ZajacPi/Davie-Robot-Arm/docs/Photos/robot_assembled.jpeg

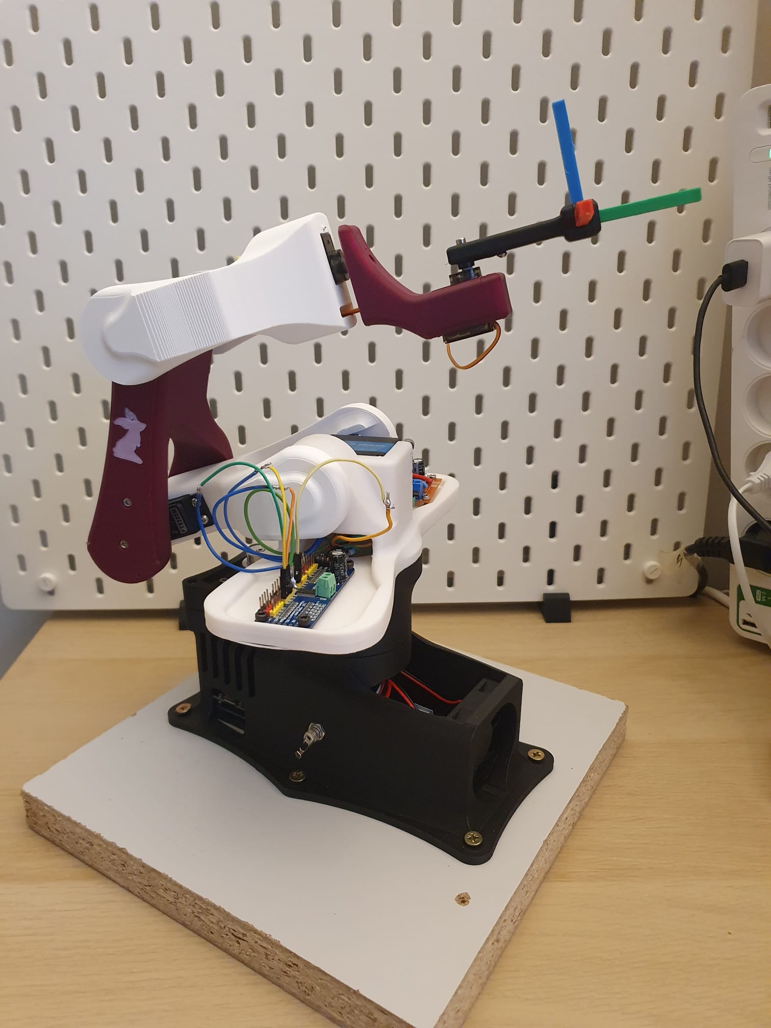
docs/Photos/robot_assembled.jpeg
