ZajacPi/Davie-Robot-Arm/docs/Photos/brass_insert.jpeg

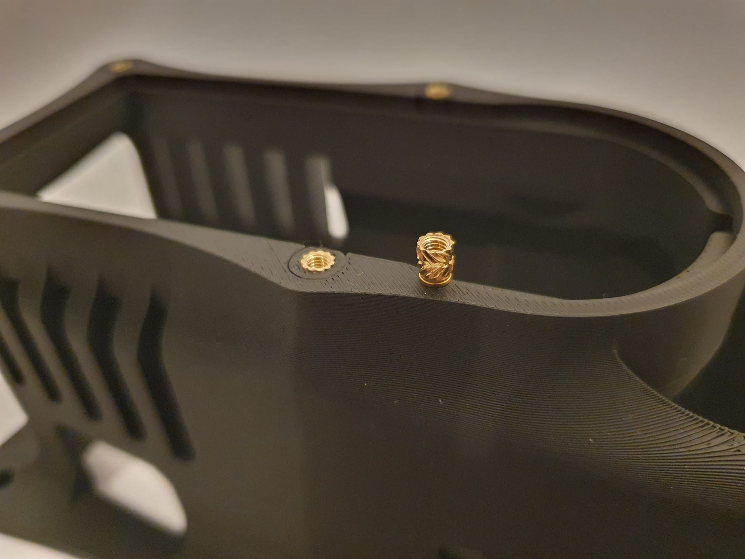
docs/Photos/brass_insert.jpeg
