ZajacPi/Davie-Robot-Arm/Documentation/Diagrams.pptx

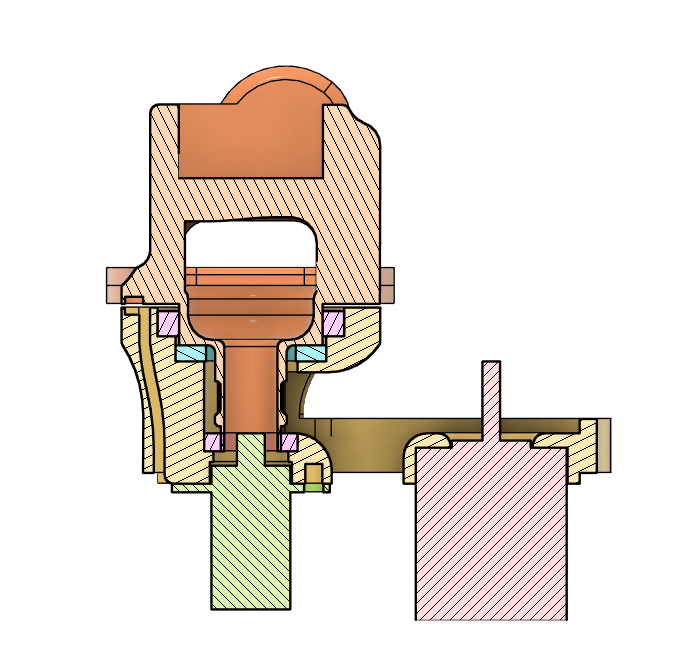
[picture p3: figure]

Rotating first axis

Magnet slot

Hollow shaft for routing cables

Rolling bearings

Hall-effect sensor slot with tunel for routing cables

Needle bearing

Hole for brass insert

Slip ring

Stepper motor

## Slide 2

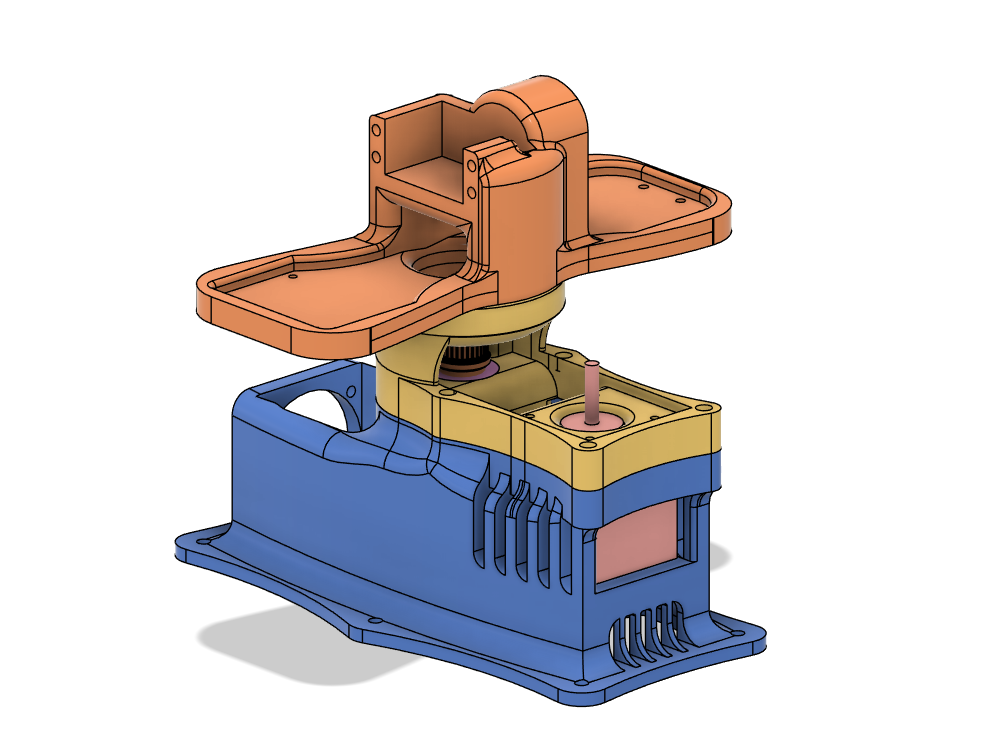
[picture p4: figure]
Obraz zawierający kreskówka Zawartość wygenerowana przez AI może być niepoprawna.

## Slide 3

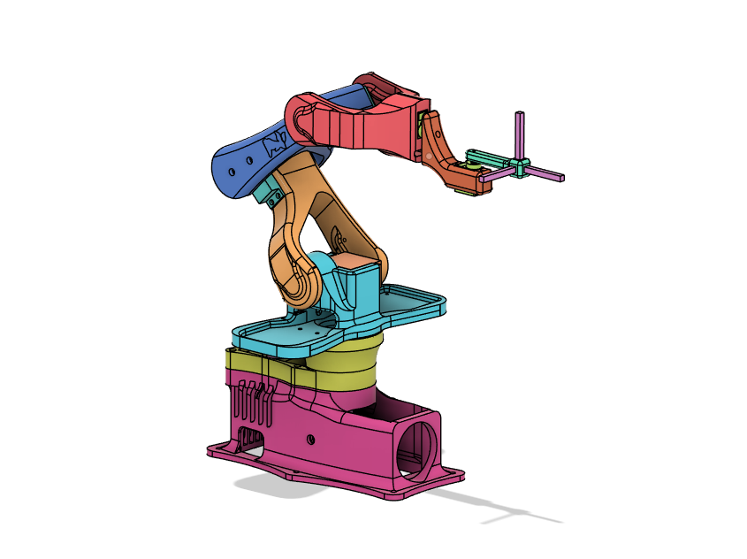
[picture p5: figure]
Obraz zawierający zabawka, rysowanie, kreskówka, szkic Zawartość wygenerowana przez AI może być niepoprawna.
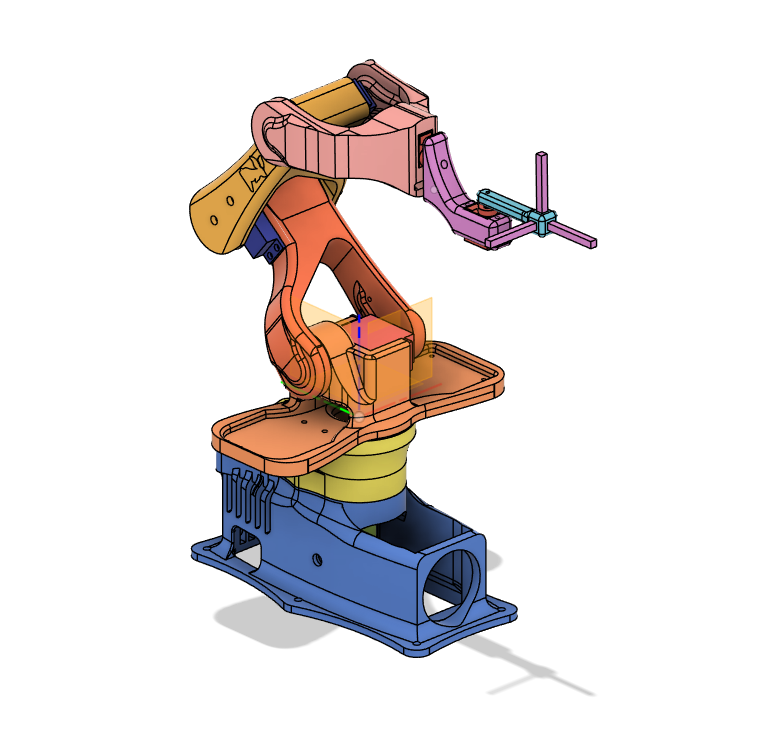
[picture p6: figure]
Obraz zawierający zabawka, rysowanie, kreskówka Zawartość wygenerowana przez AI może być niepoprawna.
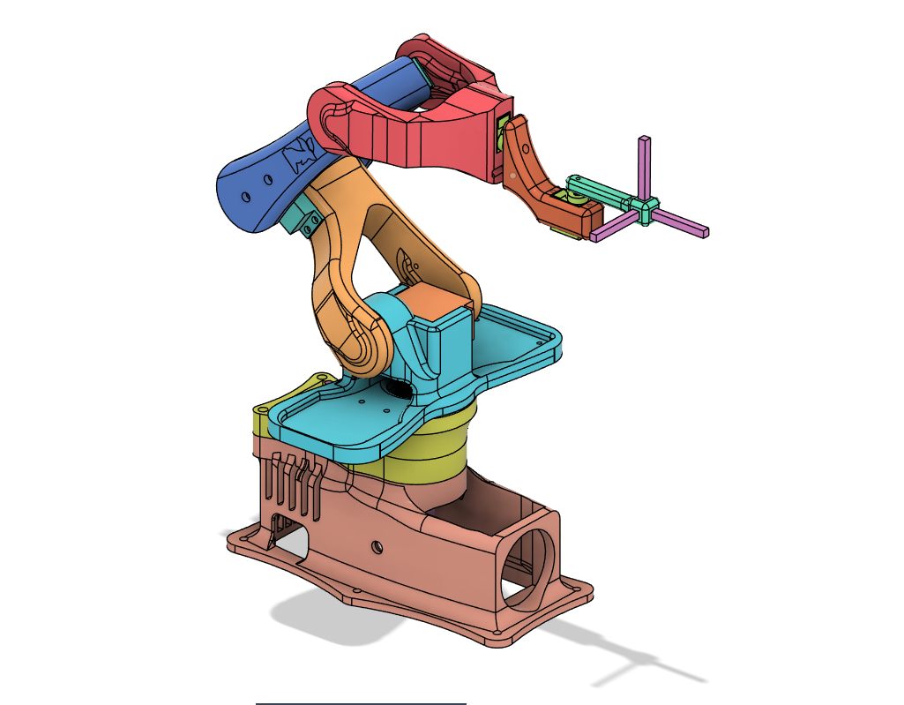
[picture p7: figure]
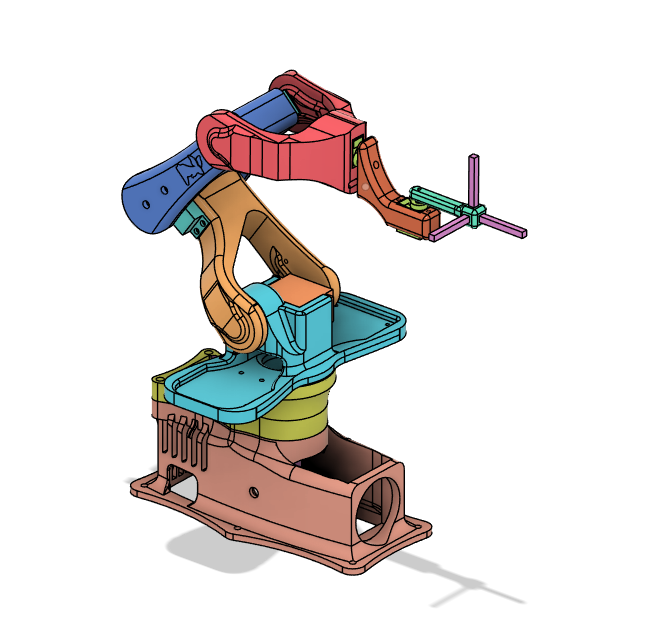
[picture p8: figure]
Obraz zawierający rysowanie, szkic, zabawka, kreskówka Zawartość wygenerowana przez AI może być niepoprawna.
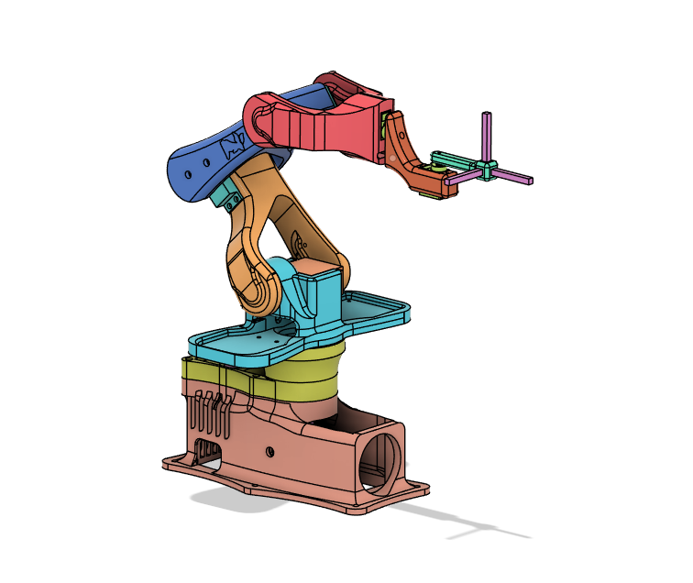
[picture p9: figure]
Obraz zawierający rysowanie, zabawka, szkic, kreskówka Zawartość wygenerowana przez AI może być niepoprawna.

## Slide 4

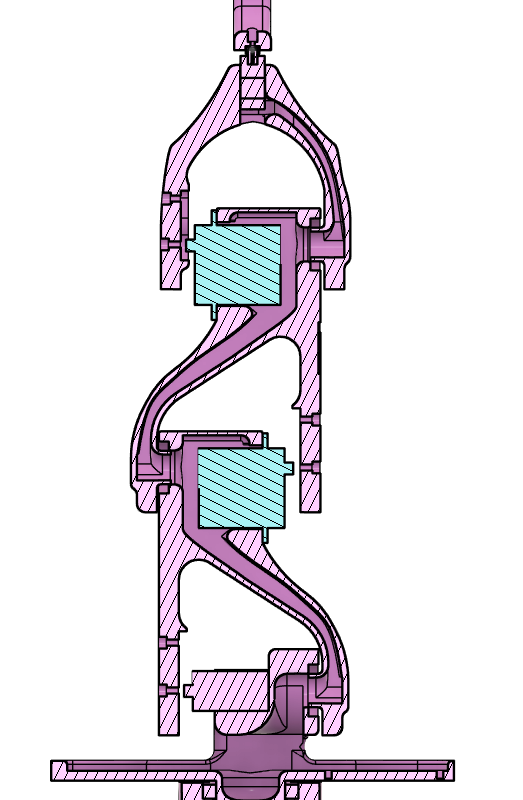
[picture p10: figure]
Obraz zawierający szkic, rysowanie, diagram, sztuka Zawartość wygenerowana przez AI może być niepoprawna.
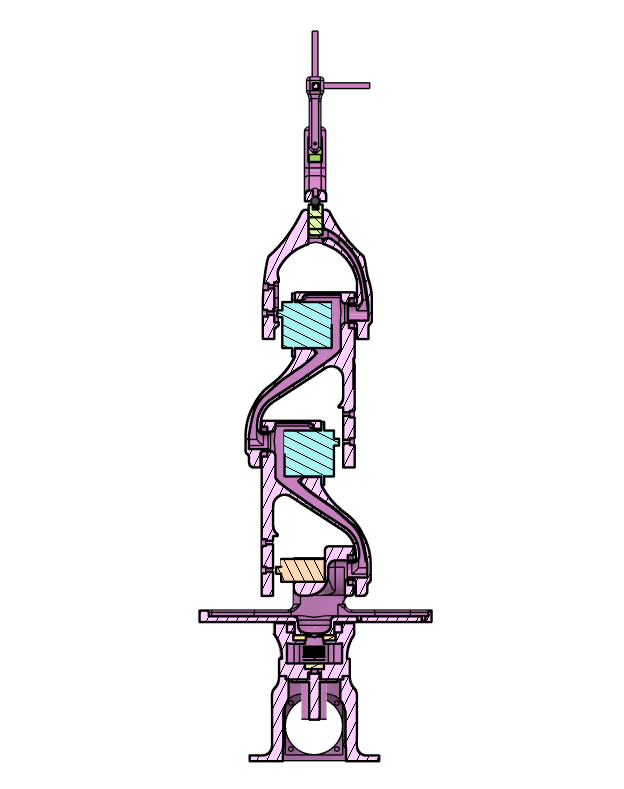
[picture p11: figure]
Obraz zawierający szkic, rysowanie, sztuka, Sztuka dziecięca Zawartość wygenerowana przez AI może być niepoprawna.
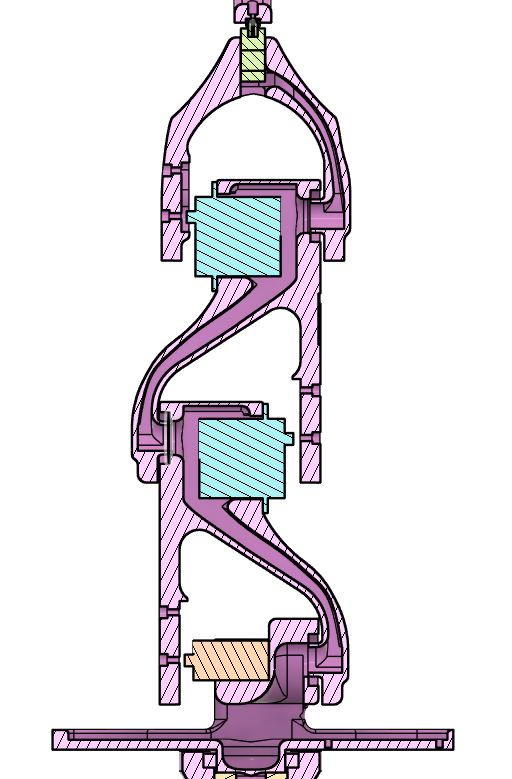
[picture p12: figure]
Obraz zawierający szkic, rysowanie, sztuka, ilustracja Zawartość wygenerowana przez AI może być niepoprawna.
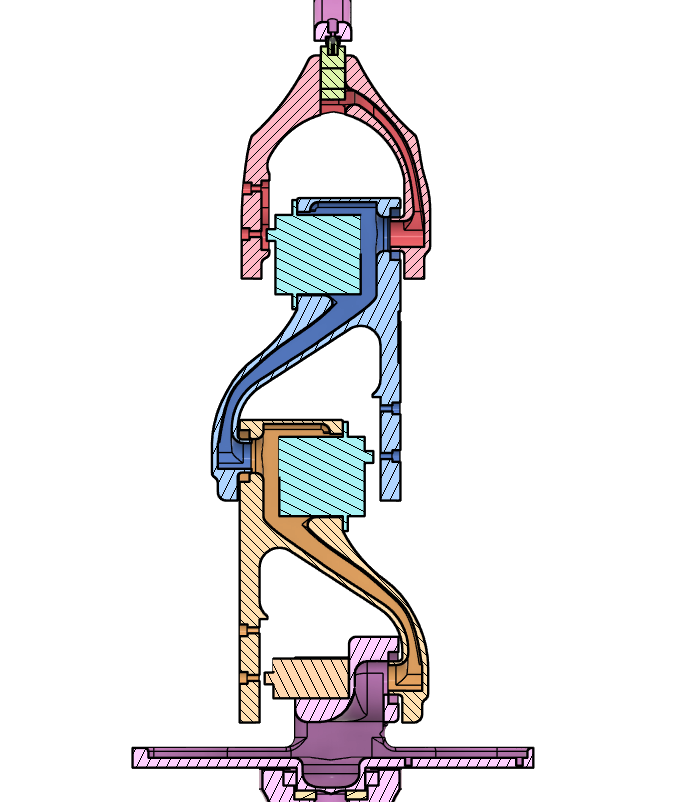
[picture p13: figure]
Obraz zawierający rysowanie, szkic, clipart, Sztuka dziecięca Zawartość wygenerowana przez AI może być niepoprawna.
