ZajacPi/Davie-Robot-Arm/david_ws/frames_2025-11-15_11.10.46.pdf

view_frames Result

Recorded at time: 1763201446.6545582

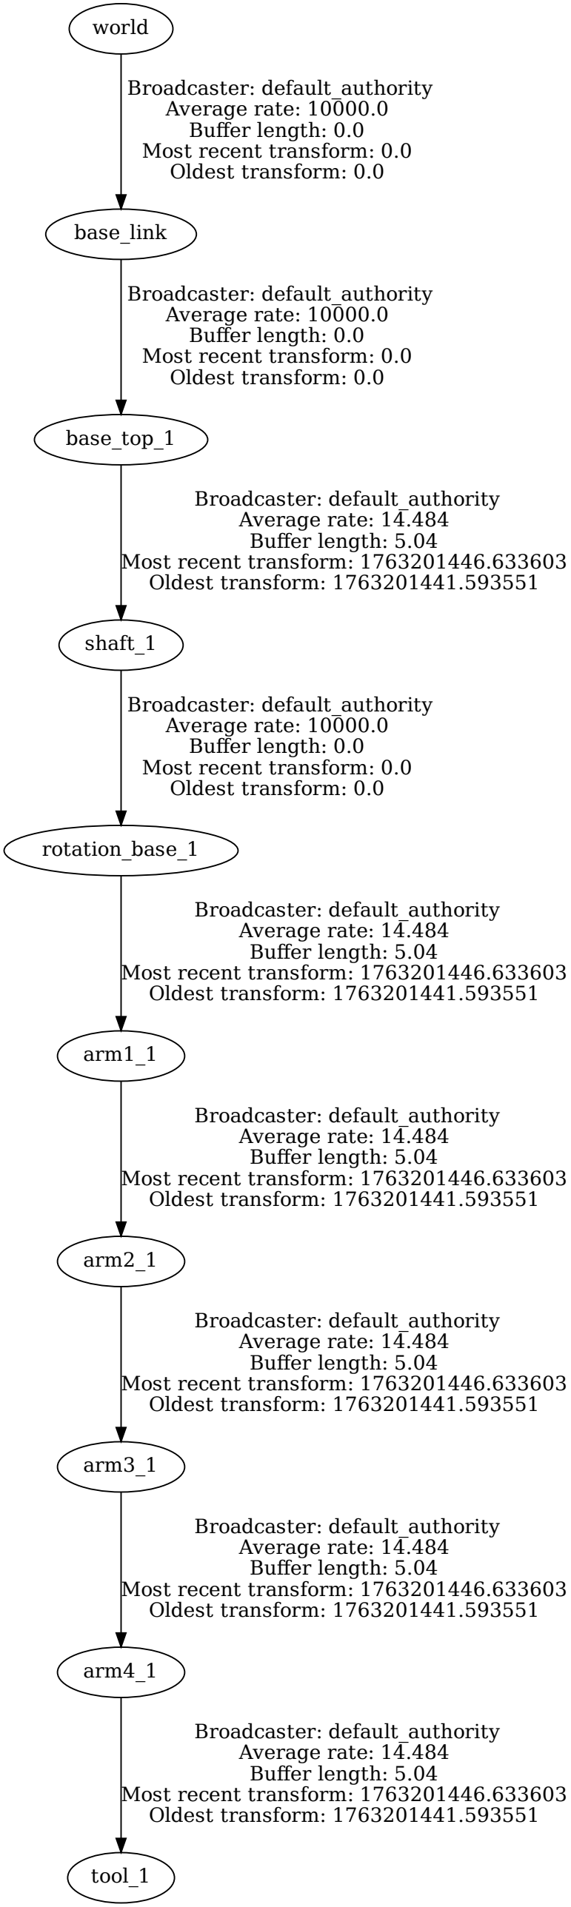
[picture p14: figure]
base_link; base_top_1; Broadcaster: default_authority Average rate: 10000.0 Buffer length: 0.0 Most recent transform: 0.0 Oldest transform: 0.0; shaft_1; Broadcaster: default_authority Average rate: 14.484 Buffer length: 5.04 Most recent transform: 1763201446.633603 Oldest transform: 1763201441.593551; world; rotation_base_1; arm1_1; arm2_1; arm3_1; arm4_1; tool_1
