ZajacPi/Davie-Robot-Arm/david_ws/frames_2025-11-27_08.39.21.pdf

view_frames Result

Recorded at time: 1764229161.7200086

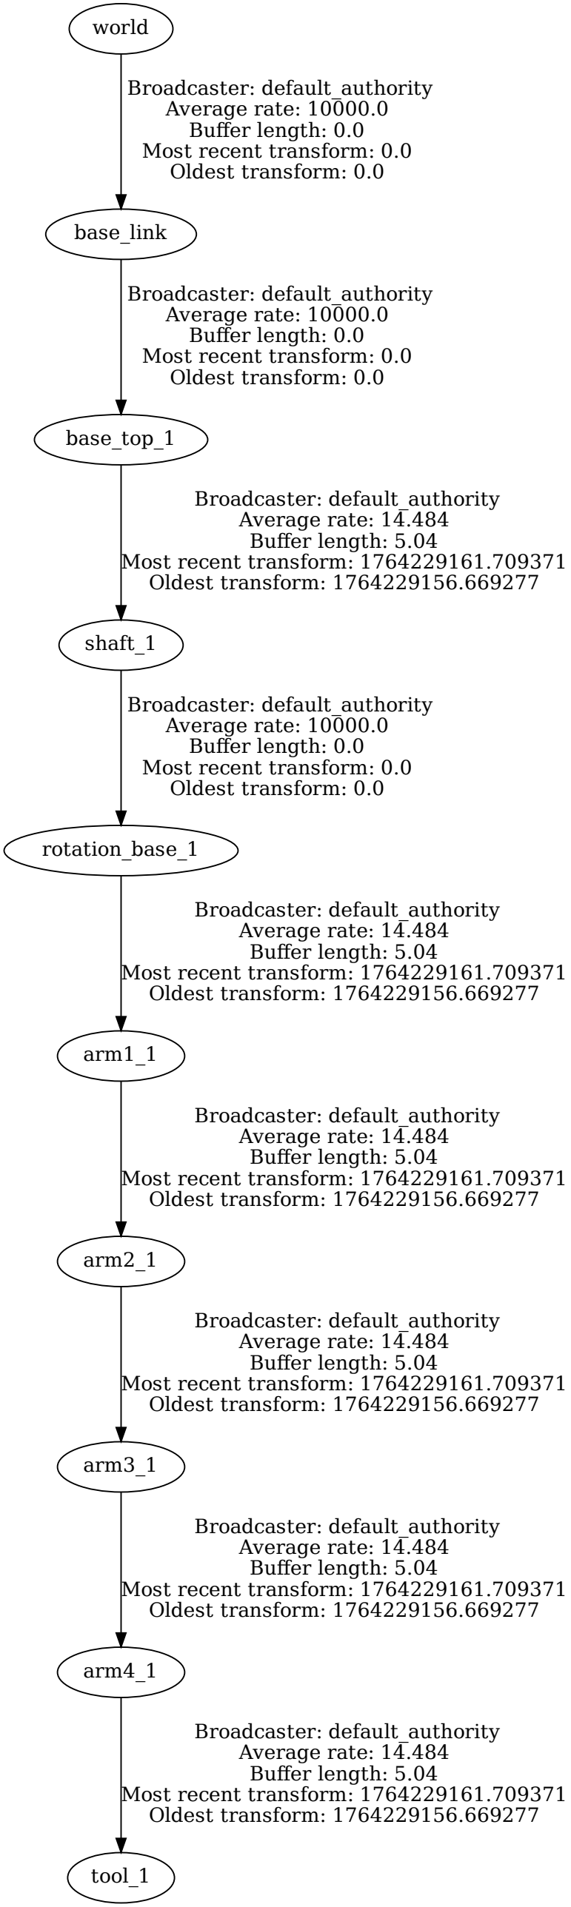
[picture p15: figure]
world; base_link; Broadcaster: default_authority Average rate: 10000.0 Buffer length: 0.0 Most recent transform: 0.0 Oldest transform: 0.0; base_top_1; shaft_1; Broadcaster: default_authority Average rate: 14.484 Buffer length: 5.04 Most recent transform: 1764229161.709371 Oldest transform: 1764229156.669277; rotation_base_1; arm1_1; arm2_1; arm3_1; arm4_1; tool_1
