ZajacPi/Davie-Robot-Arm/docs/Diagrams/base_diagram.jpg

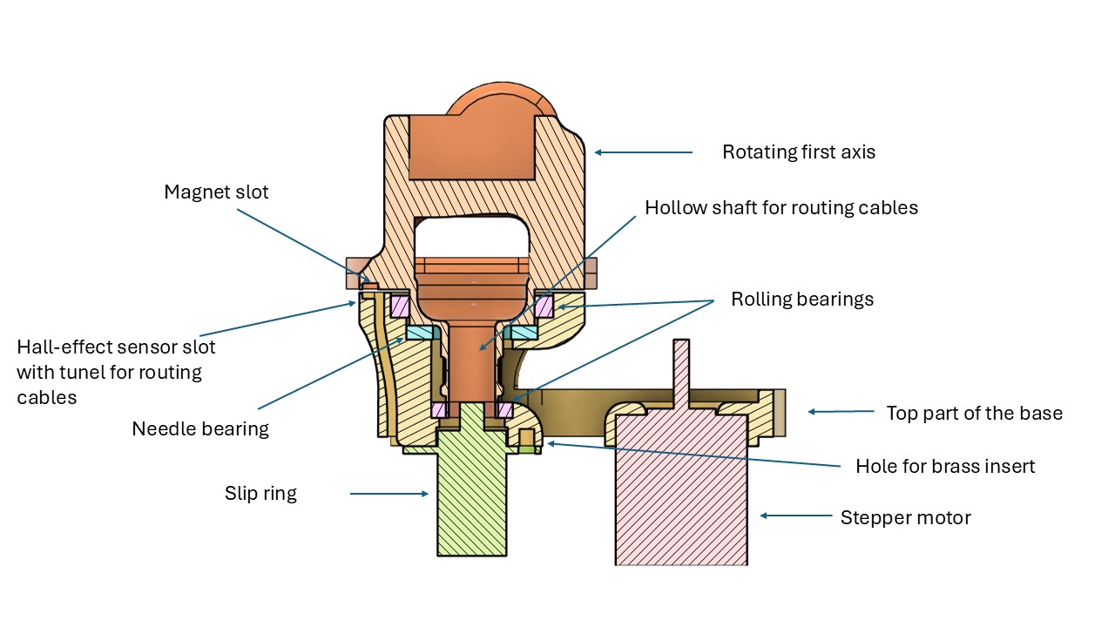
docs/Diagrams/base_diagram.jpg
