ZajacPi/Davie-Robot-Arm/docs/Diagrams/power_distribution_diagram.png

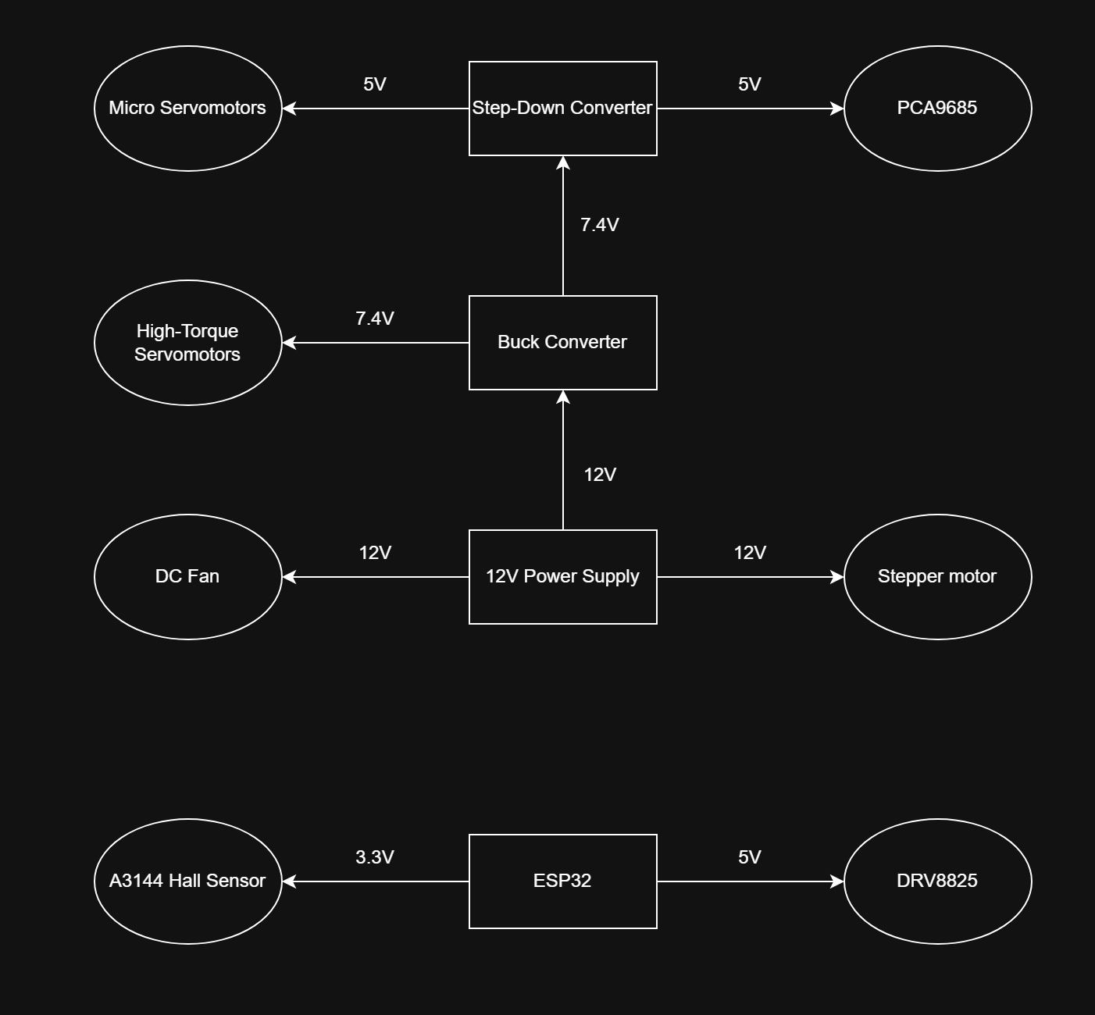
docs/Diagrams/power_distribution_diagram.png
