ZajacPi/Davie-Robot-Arm/docs/Diagrams/project_architecture_diagram.png

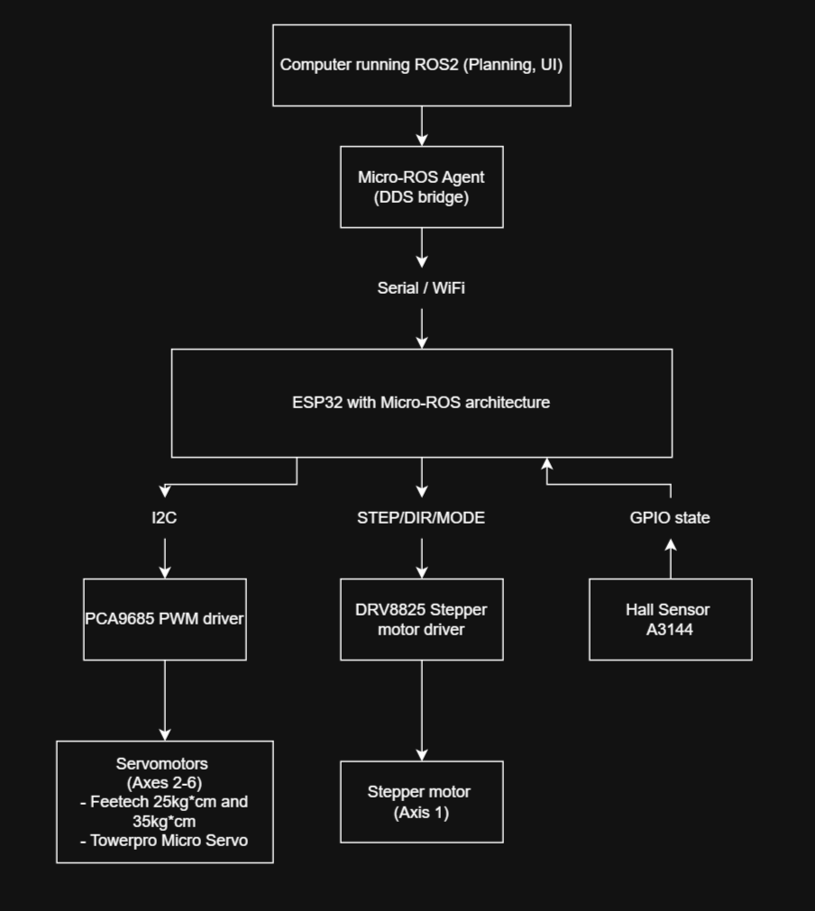
docs/Diagrams/project_architecture_diagram.png
