ZajacPi/Davie-Robot-Arm/docs/Diagrams/software_architecture_diagram.png

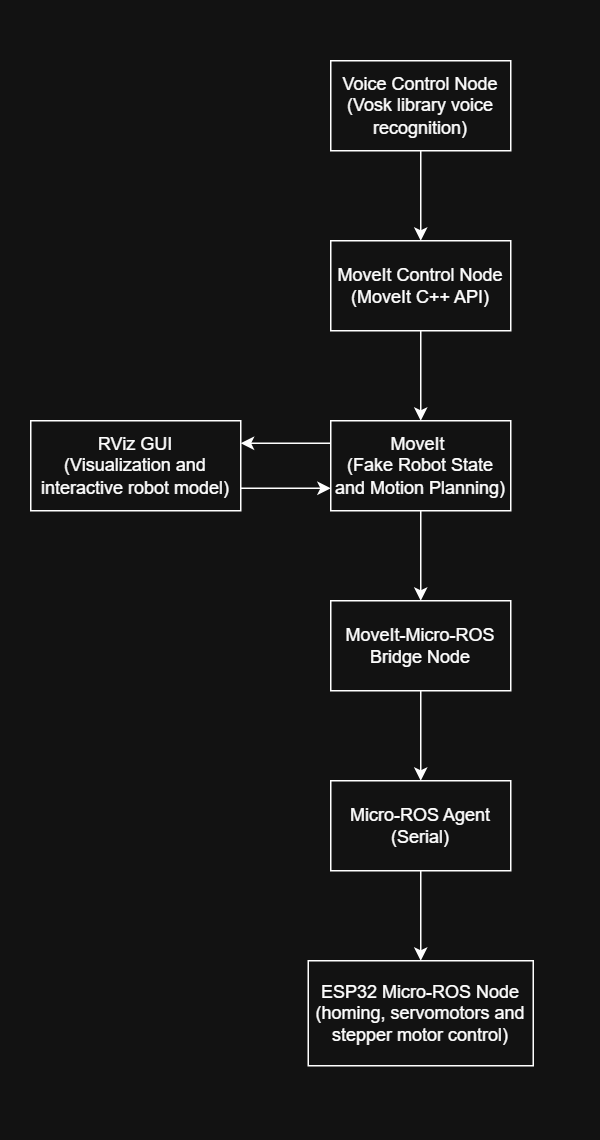
docs/Diagrams/software_architecture_diagram.png
