ZajacPi/Davie-Robot-Arm/docs/Photos/base_top.png

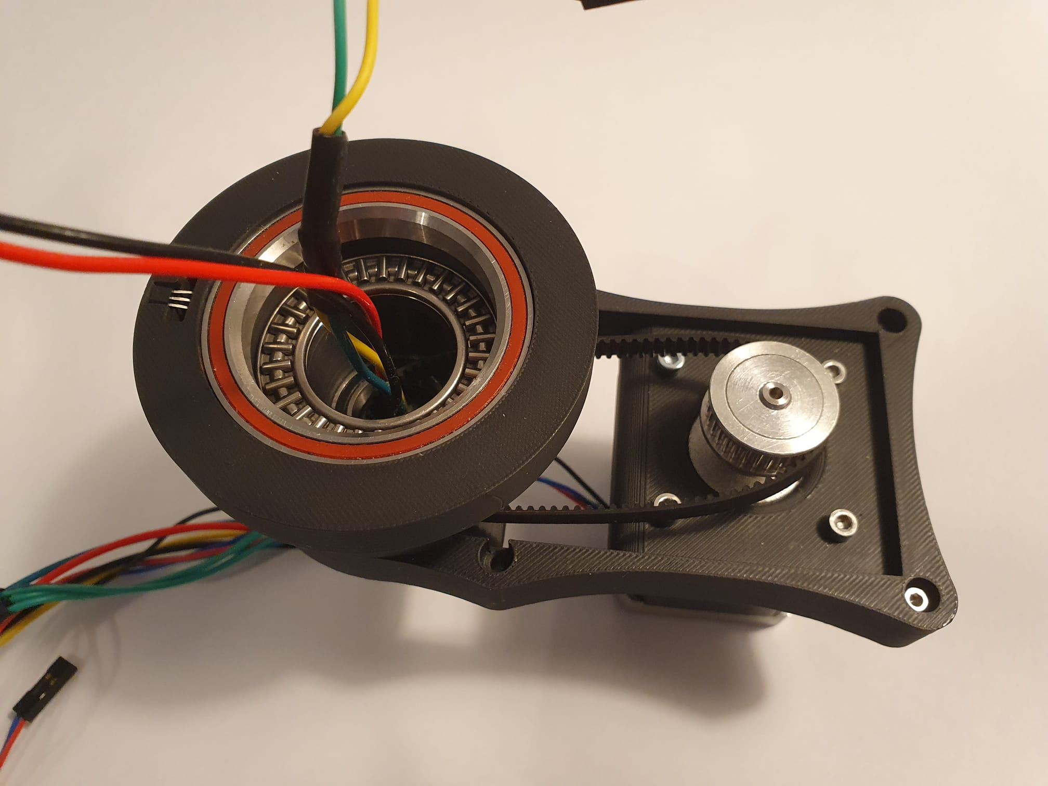
docs/Photos/base_top.png
