ZajacPi/Davie-Robot-Arm/docs/Photos/base_top_sideview.jpeg

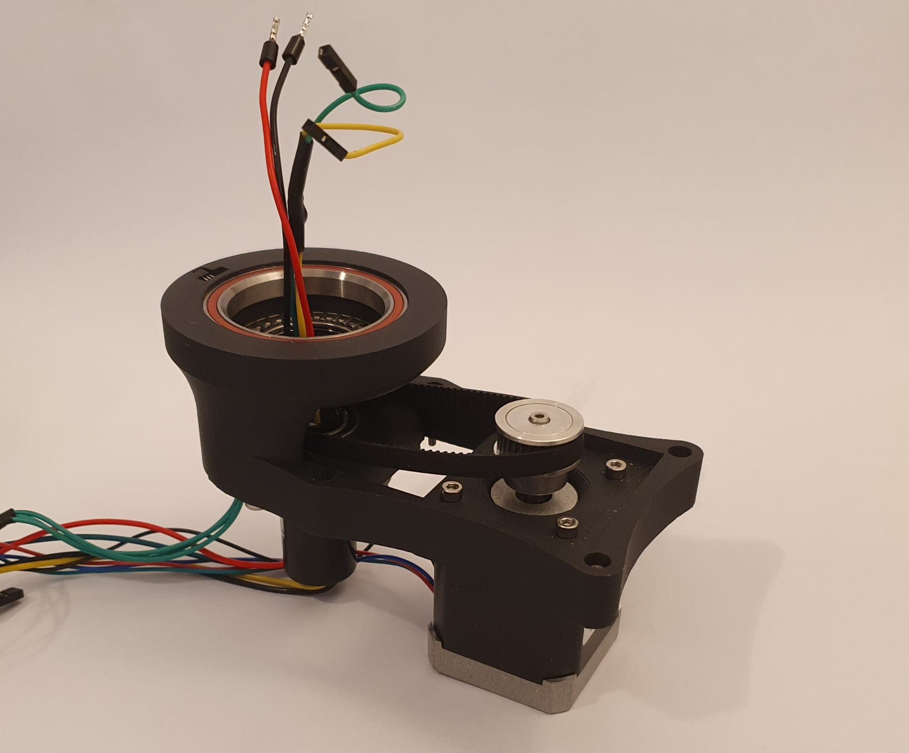
docs/Photos/base_top_sideview.jpeg
