ZajacPi/Davie-Robot-Arm/Documentation/cables_through_bearing.jpg

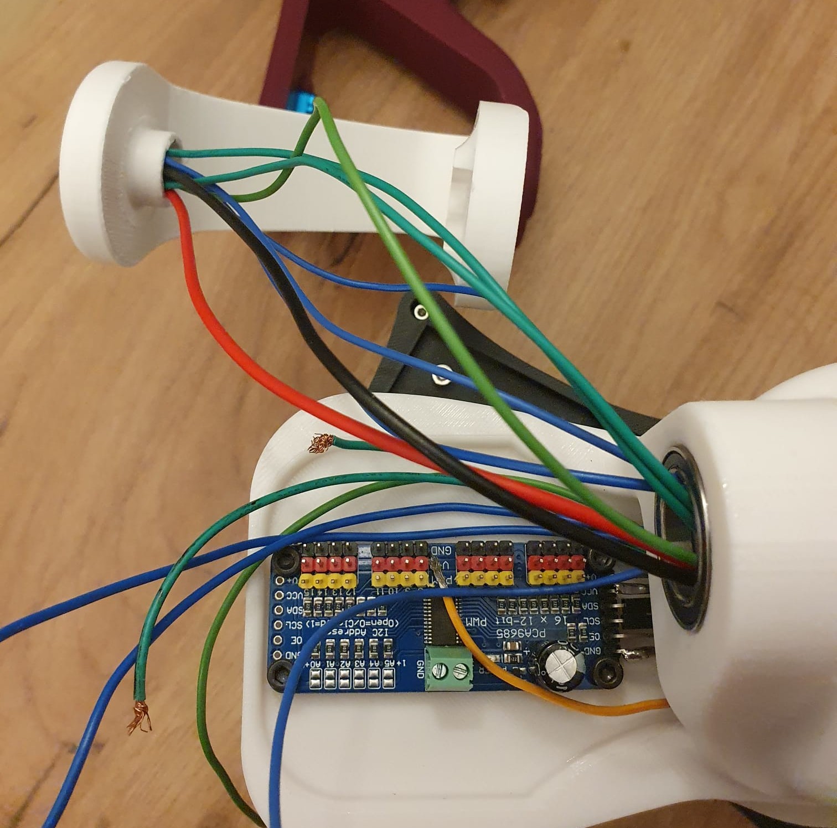
Documentation/cables_through_bearing.jpg
