ZajacPi/Davie-Robot-Arm/Documentation/full_base.jpeg

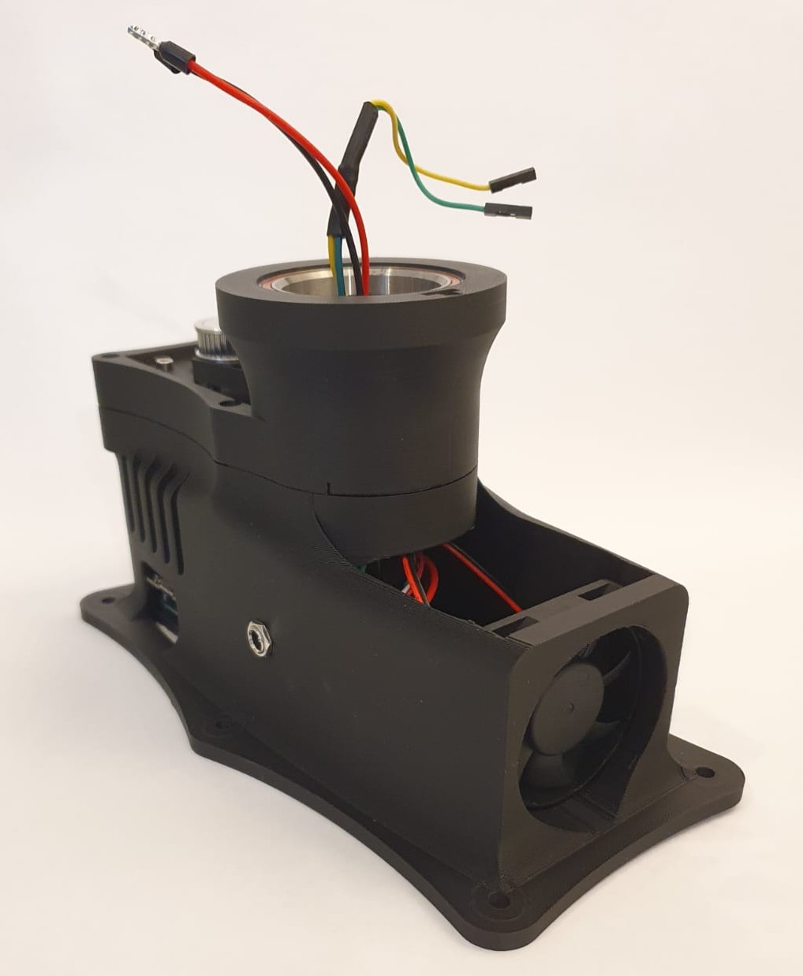
Documentation/full_base.jpeg
