ZajacPi/Davie-Robot-Arm/Documentation/Slip ring.png

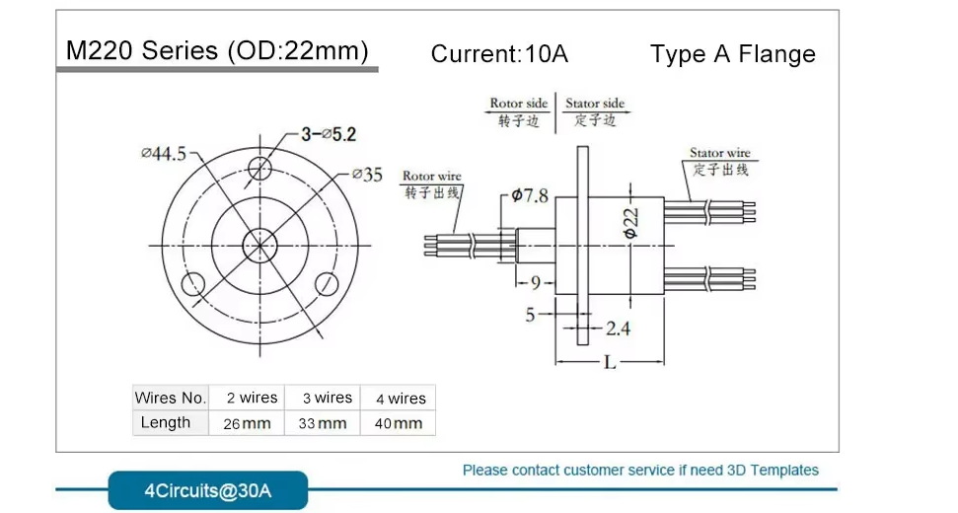
Documentation/Slip ring.png
