ZajacPi/Davie-Robot-Arm/Documentation/TCP.jpeg

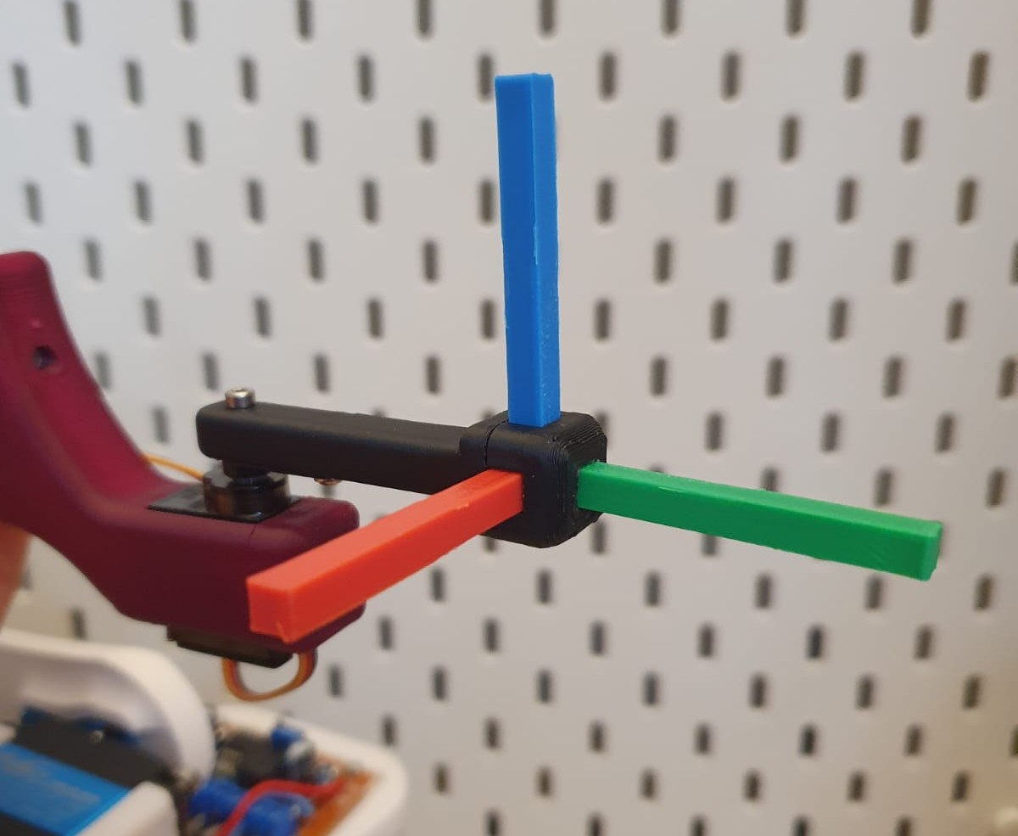
Documentation/TCP.jpeg
