ZajacPi/Davie-Robot-Arm/david_ws/src/urdf5_description/meshes/tool_1.stl

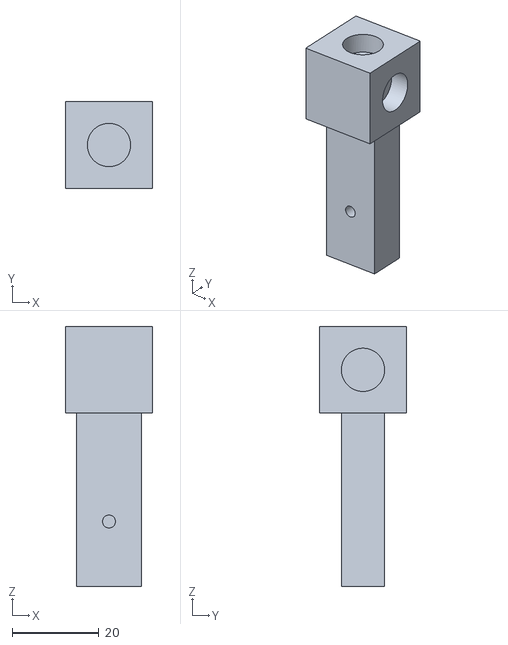
[picture p26: CAD file, 2025-12-16]
david_ws/src/urdf5_description/meshes/tool_1.stl
20.0 x 20.0 x 60.0
