ZajacPi/Davie-Robot-Arm/URDF_file/urdf6_description/meshes/calibration_rod_1.stl

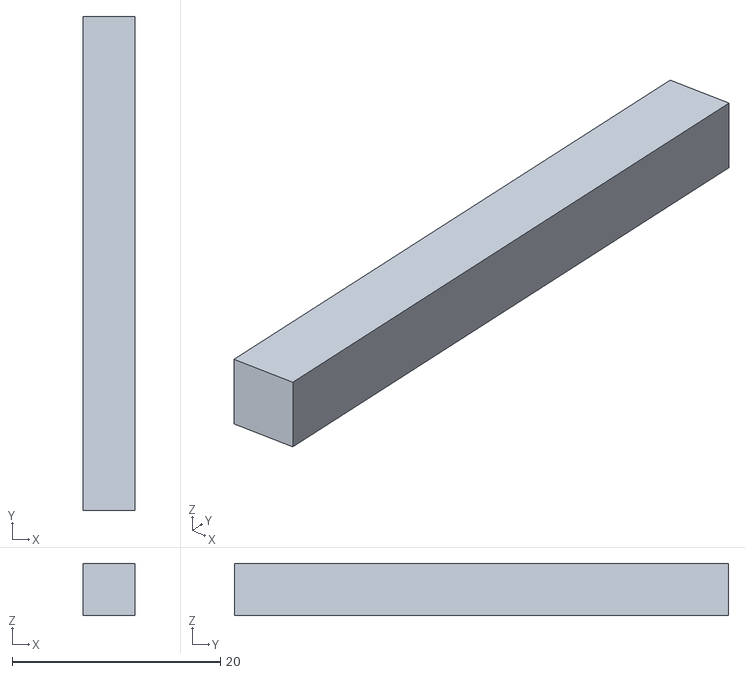
[picture p27: CAD file, 2026-01-05]
URDF_file/urdf6_description/meshes/calibration_rod_1.stl
5.00 x 47.5 x 5.00
