ZajacPi/Davie-Robot-Arm/URDF_file/urdf6_description/meshes/calibration_tool_1.stl

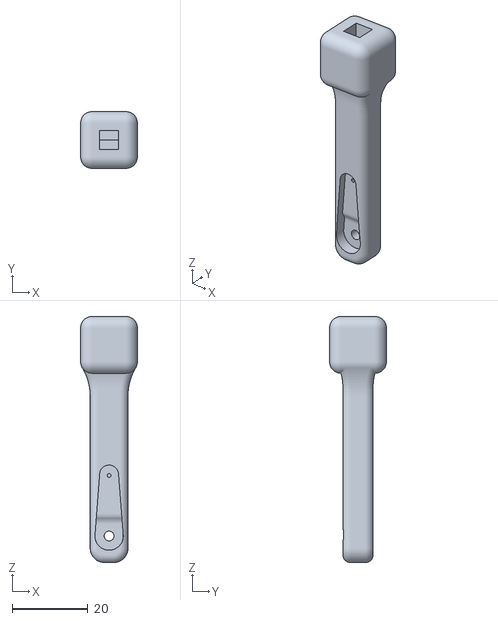
[picture p28: CAD file, 2026-01-05]
URDF_file/urdf6_description/meshes/calibration_tool_1.stl
15.0 x 15.0 x 65.0
