ZajacPi/Davie-Robot-Arm/URDF_file/urdf6_description/meshes/base_link.stl

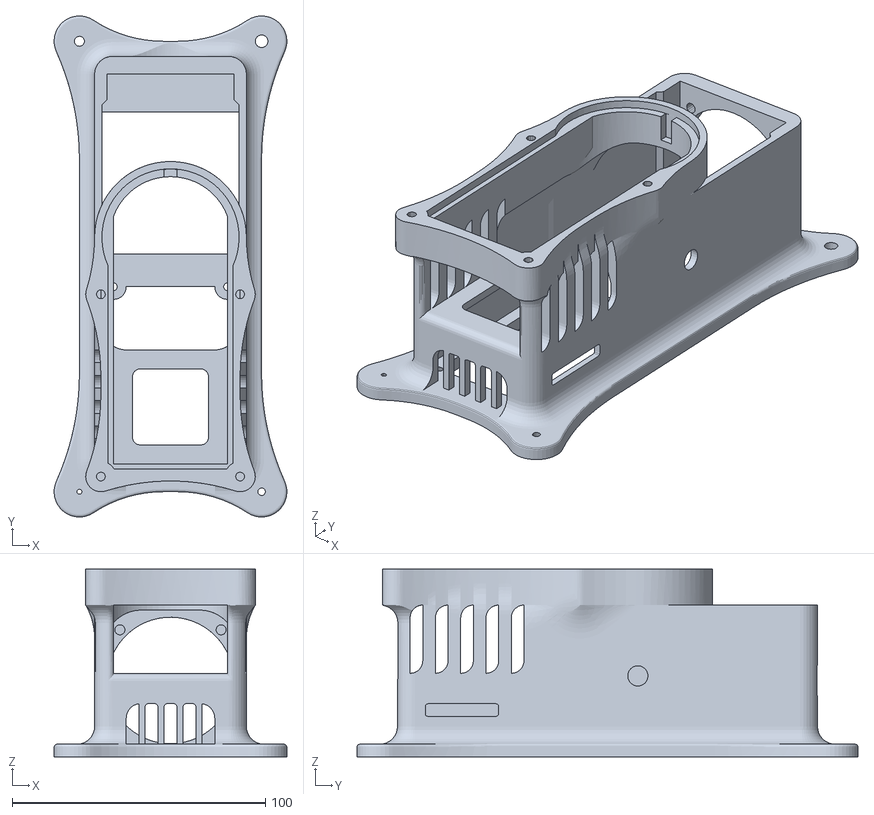
[picture p29: CAD file, 2025-12-16]
URDF_file/urdf6_description/meshes/base_link.stl
92.0 x 198.0 x 74.2
