ZajacPi/Davie-Robot-Arm/URDF_file/urdf6_description/meshes/arm4_1.stl

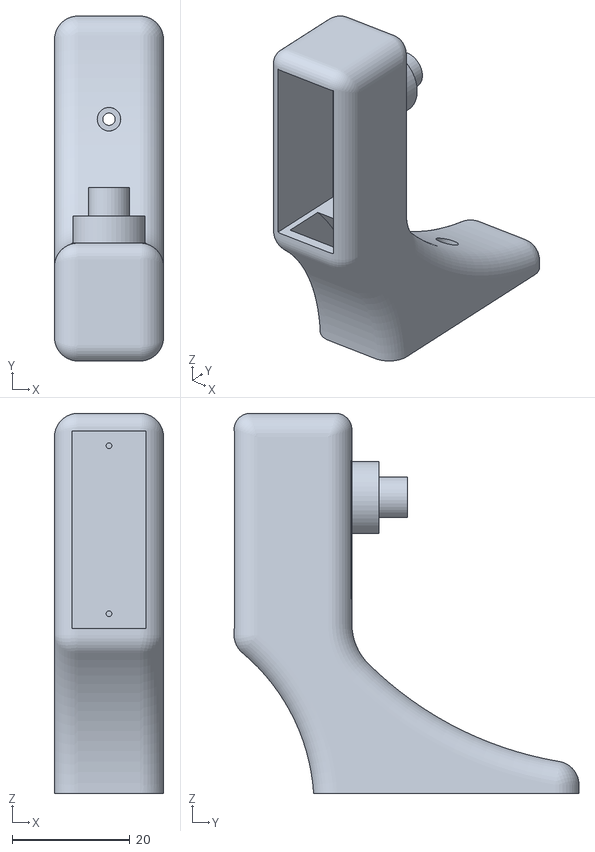
[picture p30: CAD file, 2025-12-16]
URDF_file/urdf6_description/meshes/arm4_1.stl
18.5 x 58.5 x 64.5
