ZajacPi/Davie-Robot-Arm/URDF_file/urdf6_description/meshes/base_top_1.stl

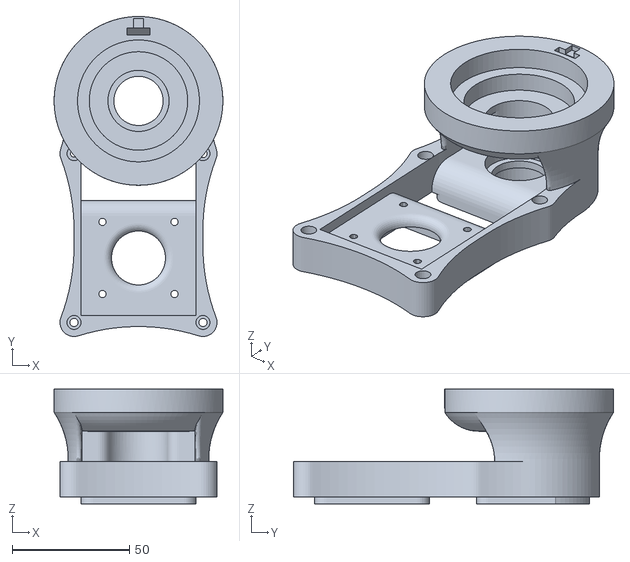
[picture p31: CAD file, 2025-12-16]
URDF_file/urdf6_description/meshes/base_top_1.stl
72.0 x 136.5 x 49.0
