ZajacPi/Davie-Robot-Arm/URDF_file/urdf6_description/meshes/arm3_1.stl

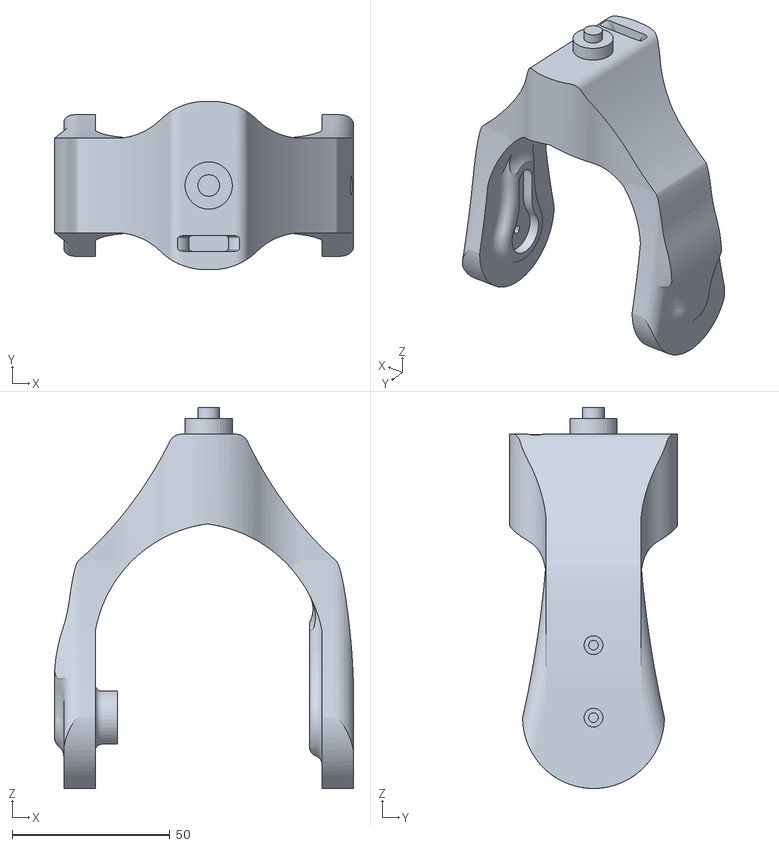
[picture p32: CAD file, 2025-12-16]
URDF_file/urdf6_description/meshes/arm3_1.stl
95.0 x 53.4 x 120.9
