ZajacPi/Davie-Robot-Arm/URDF_file/urdf6_description/meshes/arm2_1.stl

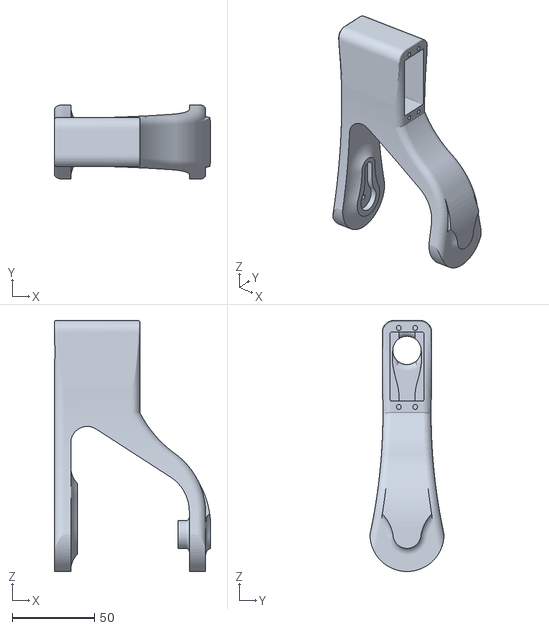
[picture p33: CAD file, 2025-12-16]
URDF_file/urdf6_description/meshes/arm2_1.stl
95.0 x 45.0 x 152.5
