ZajacPi/Davie-Robot-Arm/URDF_file/urdf6_description/meshes/shaft_1.stl

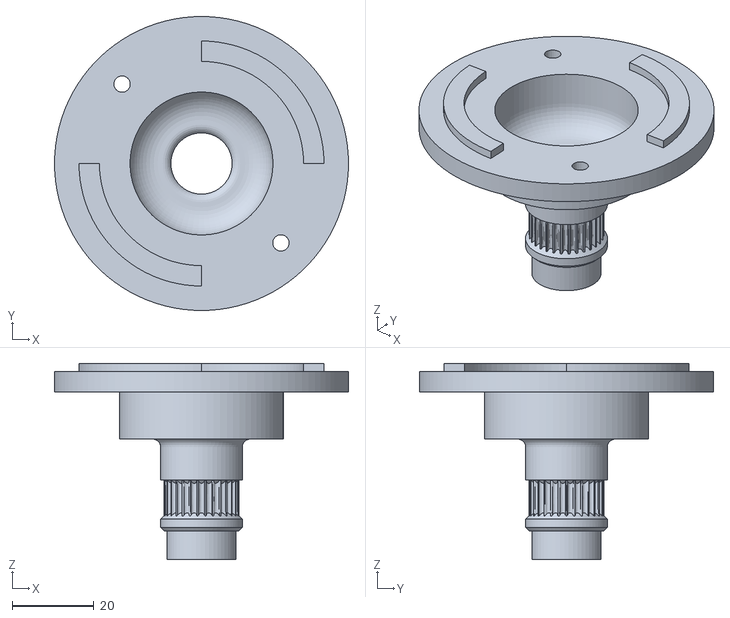
[picture p34: CAD file, 2025-12-16]
URDF_file/urdf6_description/meshes/shaft_1.stl
72.0 x 72.0 x 48.0
