ZajacPi/Davie-Robot-Arm/URDF_file/urdf6_description/meshes/rotation_base_1.stl

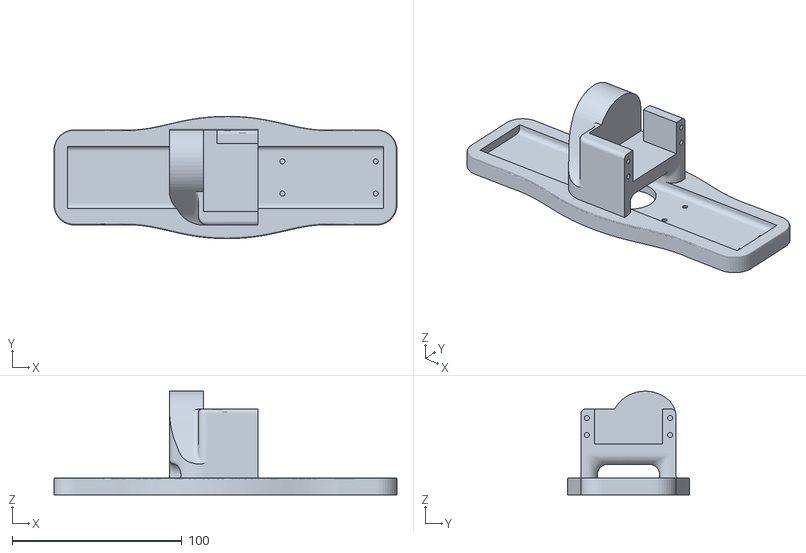
[picture p35: CAD file, 2025-12-16]
URDF_file/urdf6_description/meshes/rotation_base_1.stl
202.0 x 72.0 x 61.1
