ZajacPi/Davie-Robot-Arm/(list of files, cad)

Other CAD files:
URDF_file/urdf4_description/meshes/tool_1.stl
URDF_file/urdf6_description/meshes/arm1_1.stl
URDF_file/urdf4_description/meshes/rotation_base_1.stl
URDF_file/urdf4_description/meshes/arm2_1.stl
URDF_file/urdf4_description/meshes/arm3_1.stl
URDF_file/urdf4_description/meshes/arm1_1.stl
URDF_file/urdf4_description/meshes/arm4_1.stl
3D_Models/Arm1.ipt
3D_Models/Arm1_new.ipt
3D_Models/Arm2.ipt
3D_Models/Arm3.ipt
3D_Models/Arm4.ipt
3D_Models/Assemblies/Base_3.iam
3D_Models/Assemblies/Full_model.iam
3D_Models/Assemblies/New base.iam
3D_Models/Assemblies/top_base.iam
3D_Models/Base_bottov4.ipt
3D_Models/Base_rotation.ipt
3D_Models/Base_top.ipt
3D_Models/Component models/Gear drive.ipt
3D_Models/Component models/Slip_ring.ipt
3D_Models/Component models/Stepper.ipt
3D_Models/Component models/TowerPro SG90 M.ipt
3D_Models/Component models/big_bearing.ipt
3D_Models/Component models/feetech_25kg_servo.ipt
3D_Models/Component models/small_bearing.ipt
3D_Models/Full_model.iam
3D_Models/arm2_new.ipt
3D_Models/calibration_tool_v2.ipt
3D_Models/full_axis.iam
3D_Models/long_rod.ipt
3D_Models/motherboard.ipt
3D_Models/short_rod.ipt
URDF_file/urdf4_description/meshes/shaft_1.stl
