ZajacPi/Davie-Robot-Arm/URDF_file/srdf3/config/initial_positions.yaml

# Default initial positions for urdf4's ros2_control fake system

initial_positions:
  joint1: 0
  joint2: 0
  joint3: 0
  joint4: 0
  joint5: 0
  joint6: 0
