ZajacPi/Davie-Robot-Arm/(commit log)

2025-04-09 Add raspberry files
2025-08-29 Fixes, added servo models, made assembly
    [Arm1.0002.ipt, Arm1_1.0004.ipt, Arm1_1.ipt, Arm2.0025.ipt, Arm2.ipt, Arm4.0014.ipt, Arm4.ipt, Full_model.0007.iam]
2025-08-29 Fixed Arm2
    [Arm2.0025.ipt, Arm2.0029.ipt, Arm2.ipt]
2025-09-04 Update of parts
    [Arm1.ipt, Arm1_2servos.0004.ipt, Arm1_2servos.ipt, Arm2.0029.ipt, Arm2.0031.ipt, Arm2.ipt, Arm2.stl, Arm3.0009.ipt]
2025-09-04 Arm2 some touches
    Deeper cable servo-inserting tunnel, more space under the servo for cables, wider servo horn (15.1mm -> 16mm inner diameter)
    [Arm2.0031.ipt, Arm2.0034.ipt, Arm2.ipt]
2025-10-02 Cleanup and parts updates
    [Arm1.ipt, Arm1_2servos.ipt, Arm2.0034.ipt, Arm2.0041.ipt, Arm2.ipt, Arm2.stl, Arm2_2SERVO.0002.ipt, Arm3.0009.ipt]
2025-10-08 Created an URDF file
    [Arm1_1.stl, Arm2_1.stl, Arm3_1.stl, David_assembly.xacro, Rotation_axis_1.stl, base_link.stl, controller.yaml, materials.xacro]
2025-10-26 model updates, tests with stepper
    [Arm3.0017.ipt, Arm3.0018.ipt, Arm3.ipt, Assembly1.0007.iam, Assembly1.iam, Base__full.0001.ipt, Base__full.ipt, Base_bottom.ipt]
2025-11-02 Created axis shaft
    [Assembly2.0001.iam, Assembly2.iam, Axis1_bottom.0004.ipt, Axis1_bottom.0007.ipt, Axis1_bottom.ipt, Axis1_top.0004.ipt, Axis1_top.ipt, Shaft.ipt]
2025-11-02 Last part as step
    [Axis1_top.stp]
2025-11-06 Clean up models
    [Arm1_2servos.ipt, Arm2.dwg, Assembly2.iam, Axis1_bottom.ipt, Axis1_shaft.0006.ipt, Axis1_shaft.ipt, Axis1_v2.ipt, Base_bottom_v2.0002.ipt]
2025-11-07 urdf 2
    [David_assembly_body.xacro, arm1_1.stl, arm2_1.stl, arm3_1.stl, arm4_1.stl, axis1_1.stl, base_link.stl, base_top_1.stl]
2025-11-07 ubuntu mess
    [Arm1_1.stl, Arm2_1.stl, Arm3_1.stl, David_assembly.xacro, Rotation_axis_1.stl, base_link.stl, controller.yaml, david_assembly.xacro]
2025-11-08 new urdf
    [arm1_1.stl, arm2_1.stl, arm3_1.stl, arm4_1.stl, axis1_1.stl, base_link.stl, base_top_1.stl, controller.yaml]
2025-11-09 New urdf with a calibration tool
    [Component28_1.stl, arm1_1.stl, arm2_1.stl, arm3_1.stl, arm4_1.stl, axis1_1.stl, base_link.stl, base_top_1.stl]
2025-11-09 Cleanup build/install/log from tracking and add .gitignore
    [Arm1_1.stl, Arm2_1.stl, Arm3_1.stl, David_assembly.xacro, Rotation_axis_1.stl, arm1_1.stl, arm2_1.stl, arm3_1.stl]
2025-11-09 Add proper .gitignore and untrack build/install/log folders
    [arm1_1.stl, arm2_1.stl, arm3_1.stl, arm4_1.stl, axis1_1.stl, base_link.stl, base_top_1.stl, controller.yaml]
2025-11-13 New URDF with fixes
    [Arm3.0018.ipt, Arm3.0020.ipt, Arm3.ipt, Arm4.0014.ipt, Arm4.0015.ipt, Arm4.ipt, arm1_1.stl, arm2_1.stl]
2025-11-14 ANOTHER URDF
    [arm1_1.stl, arm2_1.stl, arm3_1.stl, arm4_1.stl, base_link.stl, base_top_1.stl, controller.yaml, materials.xacro]
2025-11-14 Trying to make API work
    [Component28_1.stl, arm1_1.stl, arm2_1.stl, arm3_1.stl, arm4_1.stl, axis1_1.stl, base_link.stl, base_top_1.stl]
2025-11-21 Finally, a repaired URDF designed for ROS2 and fully working moveit with api
    [Arm1.0002.ipt, Arm1.ipt, Arm1_1.0004.ipt, Arm1_1.stl, Arm1_2servos.0004.ipt, Arm1_2servos.ipt, Arm2.0001.dwg, Arm2.0041.ipt]
2025-11-21 Cleanup of repository, working on microros interface
    [joint_limits.yaml]
2025-11-30 Working MoveIt bridge, user can control the robot
    [ros2_controllers.yaml]
2025-12-13 Updated 3D models
    [Arm1_new.0012.ipt, Arm1_new.3mf, Arm1_new.ipt, Arm1_new.stp, Arm3.0018.ipt, Arm3.0022.ipt, Arm3.3mf, Arm3.ipt]
2025-12-16 Powerpoint presentation for diagrams and comparing mechanical design with results
2026-01-05 URDF6 created
    [arm1_1.stl, arm2_1.stl, arm3_1.stl, arm4_1.stl, base_link.stl, base_top_1.stl, calibration_rod_1.stl, calibration_tool_1.stl]
